paxswill/CabinetFan/CabinetFan.sch

## KiCad design CabinetFan.sch (2020-09-11)

Schematic: CabinetFan.sch

Parts:
J1: Barrel_Jack
M1: Fan_4pin
R1: 15k
R2: 330
R3, R4: 10k
U1: TMP36; SOIC-8_3.9x4.9mm_P1.27mm
U2: ItsyBitsy5v

Notes on the sheet:
TACH_INPUT must be connected to an external interrupt pin.
FAN_CONTROL must be connected to a PWM pin that is connected to any of Timer/Counter1, 3, or 4 (meaning pins D5, D6, D9, D10, D11, or D13 are acceptable).
TEMP_INPUT must be connected to an analog input pin.
The fan control signal is a 5V, 25kHz PWM signal.
The tachometer signal is an open-collector, two pulse per revolution square wave that needs to be pulled up to 12V. The Noctua datasheet also specifies a maximum current of no more than 5mA. In addition, the Arduino has a maximum of 5V for its inputs. To satisfy these constraints, there's a pull up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
