paxswill/CabinetFan/CabinetFan/ConstantSpeed.h

#ifndef FAN_CONSTANT_SPEED_H
#define FAN_CONSTANT_SPEED_H

#include <math.h>
#include "FanController.h"
class ConstantSpeedController: public FanController {
  public:
    ConstantSpeedController(Fan *fan, float initialSpeed = NAN);

    // The abbreviation for the units for the set point.
    static const char * valueUnits;

    // A suggested amount to increment the set point value by.
    const float valueStep = 0.1;

    // Called each iteration of the run loop.
    virtual void periodic(unsigned long currentMillis);
  private:
    // When the fan speed was last checked.
    unsigned long lastUpdate = 0;
};
#endif
