paxswill/CabinetFan/(commit log)

2020-01-29 Start custom PWM and tach interrupt handlers
2020-01-30 Make fan PWM control a bit configurable
    Now able to switch between Fast PWM, phase-correct PWM, and phase and frequency correct PWM. The TOP value is also based off of the board’s CPU frequency.
    [CabinetFan.ino]
2020-01-30 Update the fan frequency/speed once a second
2020-01-30 Allow proper fan ramp-up time for low speeds
2020-01-30 Add periodic temperature updates
2020-02-02 Default to external temperature sensor
2020-02-02 Fix external temperature conversion
    [CabinetFan.ino]
2020-02-02 Only control one fan
    Two fans was getting too difficult to implement properly (tach readings were off), so I reduced it to just one. The hardware was also much easier to lay out and wire up.
2020-02-02 Calculate the period for frequency correctly
    It was always reading 0 as the update time was being updated before the period was calculated.
    [CabinetFan.ino]
2020-02-02 Rip out automatic ADC triggering
    It wasn’t working. I might bring it back, but at the moment I am just paring down things to get the basics working.
2020-02-02 Rename (_)setFans argument to fanSpeed
    “speed” might’ve conflicted with something going off of the highlighting in the Arduino IDE.
2020-02-02 Allow changing the speed during ramp-up
    Also implementing the reduction down to one fan for this as well.
2020-02-02 Create a Thermometer class and stop using interrupts
    The interrupt-based approach was making things more complicated than they needed to be. I also think it was leading to some issues with conversions being triggered too frequently, so the values were incorrect.
    [CabinetFan.ino, Thermometer.cpp, Thermometer.h]
2020-02-16 Extract fan control functions into separate class
2020-02-16 Update currentSpeed when setting the fan speed
2020-02-16 Fix off by one error in interrupt setup
    [Fan.cpp]
2020-02-16 Set proper pin mode for external interrupt pins
2020-02-16 Delay Fan setup to avoid being clobbered
    [CabinetFan.ino]
2020-02-16 Use ATOMIC_FORCEON
    Interrupts are always enabled, so shave down memory usage a bit.
2020-02-16 Periodically print the current speed and RPM for debugging
2020-06-14 Comment cleanup in Fan.h/Fan.cpp
2020-06-14 Make the RPM limits of the Fan class public
    This is so the constant speed fan controller can use them as the limits
    for its values.
2020-06-14 Implement a constant speed fan controller
2020-06-14 Add groundwork for selectable control schemes
    Right now just an open-loop, constant speed control scheme is
    implemented. Eventually I plan to implement closed-loop P and PI schemes
    As well.
2020-06-14 Implement a bare-bones PID fan controller
    I’m not sure it even works, and the constants chosen in the code are
    *not* tuned at all.
2020-06-14 Use duty cycle for constant speed fan controller
    Operating on RPMs is unreliable, as that’s not actually how the speed is
    set, and the RPM sensing is not reliable yet.
2020-06-14 Have a more reasonable default temperature set point
2020-06-14 Fix setting the PIDController instance names
    [PIDFanController.cpp, PIDFanController.h]
2020-06-14 Give 1 degree of slop for stopping the fan
    Not sure this is the correct method yet, I’m still playing with the
    knobs to see what works.
    [PIDFanController.cpp]
2020-06-14 Reorder Fan initializers to silence -Wreorder
2020-09-05 Pull fan RPM sensing period into a constant
2020-09-05 Fix fan tachometer sensing and RPM calculations
    This commit also corresponds to a hardware change, with a pullup resistor between the fan tachometer pin and 12V (suitably large to also minimize the current involved, as Noctua documents a limit of 5mA for their fans). There is also then a voltage divider between that pullup and the Arduino to bring the 12V down to 5V.
    Because of that hardware change, the Arduino internal pullup isn’t needed anymore. Additionally, I changed the interrupt configuration to trigger on both falling and rising edges. I also removed the check for overflowing the number of ticks, as that’s exceedingly unlikely.
    There were also a couple logic/math errors in calc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
    [Fan.cpp]
2020-09-05 Move constant speed name into constructor
    Otherwise the name wasn’t actually set, and bad things were happening.
2020-09-05 Simplify Fan constructors
    If the sensePin is set, the maxRPM can be detected from the fan by setting a 100% duty cycle and then counting the ticks after it’s up to speed.
2020-09-05 Update Fan comments
2020-09-05 Remove minRPM from Fan
    It was never actually used.
2020-09-08 Implement Printable support for FanController and Thermometer
    There’s probably going to be errors with the inheritance for FanController but I’ll fix that when I get there.
    [FanController.cpp, FanController.h, Thermometer.cpp, Thermometer.h]
2020-09-10 Add the start of a serial-based interface
    Still haven’t added a mechanism for editing values, but it’s getting
    there.
2020-09-11 Write up an actual README and add schematics and photos
    [CabinetFan.sch]
2020-09-11 Add note on vertical resistors
2020-09-11 Properly enable PWM output for all output ports.
    Previously, only port A was being enabled. I also expanded the comments
    regarding these sections.
2020-09-11 Improve documentation of Fan class
2020-09-11 Move NOT_SET sentinel out of Fan.h into Fan.cpp
    It doesn't need to be part of the public interface anymore.
    [Fan.cpp, Fan.h]
2020-09-12 Change setup10BitPWM to a method
    Slightly smaller code size, and it’s easier to maintain as a method instead of a multiline macro.
2021-08-29 Rename src to CabinetFan
    Makes it easier to use with the Arduino IDE
2021-08-29 Fix missing backslash in macro
    [Fan.cpp]
2021-08-29 Update the max RPMin Fan::periodic
2021-08-29 Implement changing the fan controller menu command
2021-08-29 Use a moving average of temperature for the PID controller
    This is an attempt to handle the pretty crazy noisy data coming off of
    the temperature (sudden spikes/drops of ~5 degrees for one measurement,
    etc).
2021-08-29 PID tuning
2021-08-30 Rewrite Thermometer::getTemperature()
    It looks more complex now, but it follows the same code path (mostly)
    for both internal and external sensors.
2021-08-30 Put the MCU to sleep during ADC conversions
    There's still a bit of noise, but it's much better than what it
    used to be.
    [Thermometer.cpp]
2021-08-30 Exclude fan speeds between 0 and 5%
2021-08-30 Change types for fan RPM tracking
2021-08-30 More PID tuning
2021-08-31 Use Idle sleep intead of noise reduction sleep
    Noise reduction sleep disables outputs, while Idle sleep keeps then
    enabled.
    [Thermometer.cpp]
2021-08-31 Move temperature averaging to Thermometer
    The Thermometer is now polled at 1Hz independently now.
2021-08-31 Remove fan actual speed calculation
    It didn't work, and the max RPM calculations needs is being worked on
    with a general calibration step.
    [Fan.cpp]
2021-08-31 Don't just turn the fan off when we're below the temperature
2021-08-31 More PID tuning, and PID loops are now 1 minute
